mattvenn/teensy-audio-fx/docs/PO_sync_mode.md

# PO sync mode

looks for full amp sync pulse on 1/8 notes on left channel.

## sync pulse

* DC, 1v peak
* 2.7ms long pulse

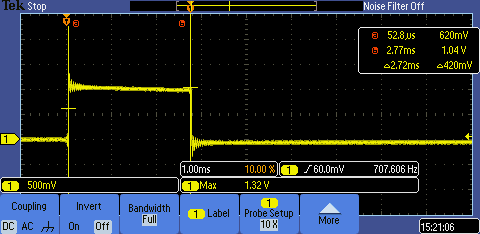
[picture p4: docs/po-sync-pulse.PNG]
sync pulse


## 2 sync pulses @ 120bpm

* showing 250ms spacing
* 120bpm is 2bps, so 8 pulses per bar of 16 steps
* 1 pulse every 2 steps

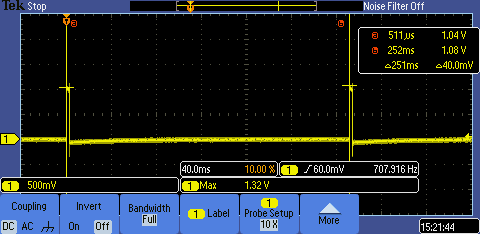
[picture p5: docs/po-sync-120bpm.PNG]
sync pulses at 120bpm
