mattvenn/teensy-audio-fx/docs/noise.md

# Noise and clock measurements

## I2S 12MHz clock

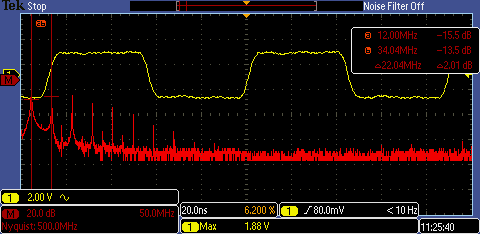
[picture p6: docs/i2s-clock.PNG]
i2s clock and fft


## Noise on input jack, nothing plugged in

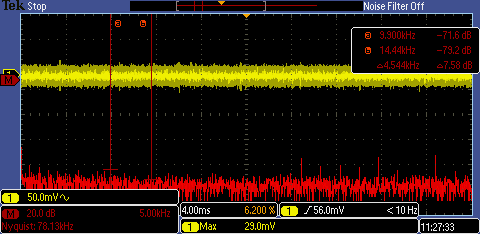
[picture p7: docs/input.PNG]
input jack


## Noise on output jack, nothing plugged in, nothing playing

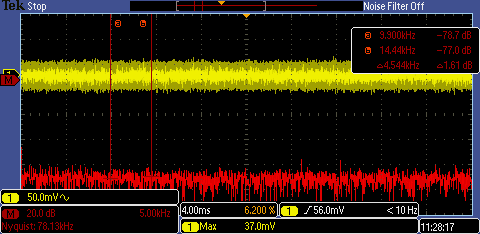
[picture p8: docs/output.PNG]
output jack
