mattvenn/teensy-audio-fx/docs/lrclk-bclk-swap.png

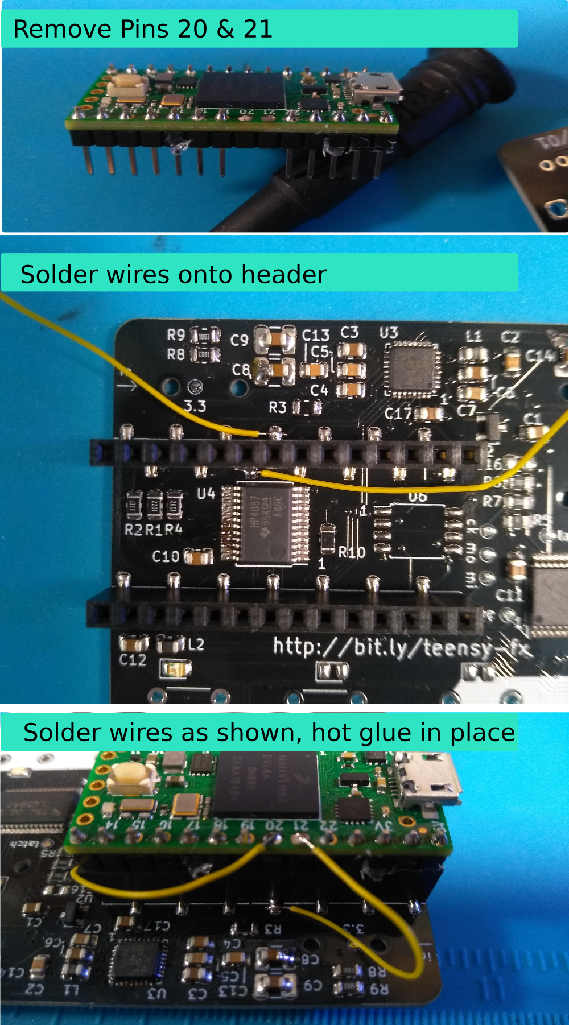
docs/lrclk-bclk-swap.png
