mattvenn/teensy-audio-fx/hardware/graphics/lab.png

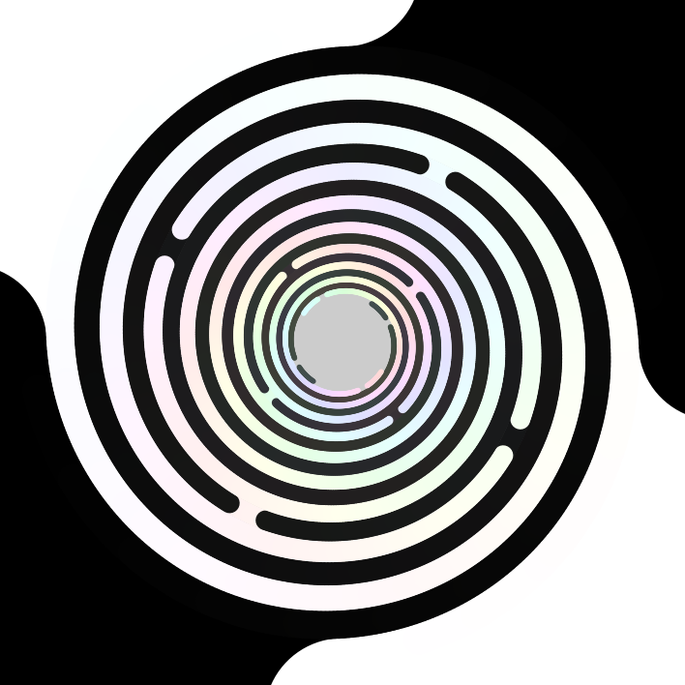
hardware/graphics/lab.png
