mattvenn/teensy-audio-fx/hardware/schematic_audio4.png

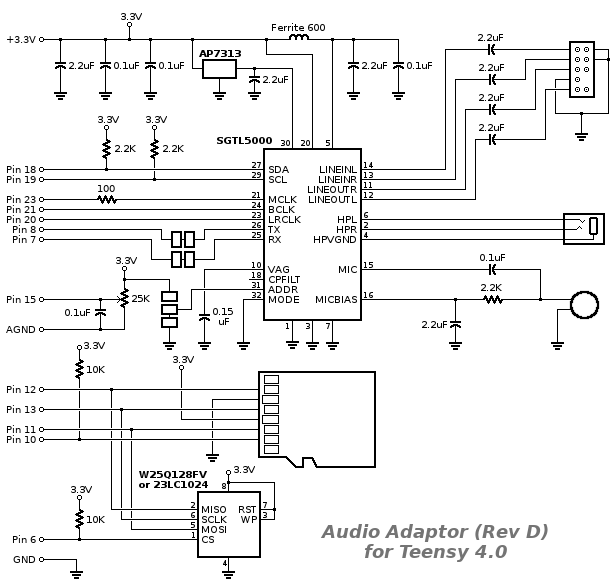
hardware/schematic_audio4.png
