mattvenn/teensy-audio-fx/hardware/teensy4.png

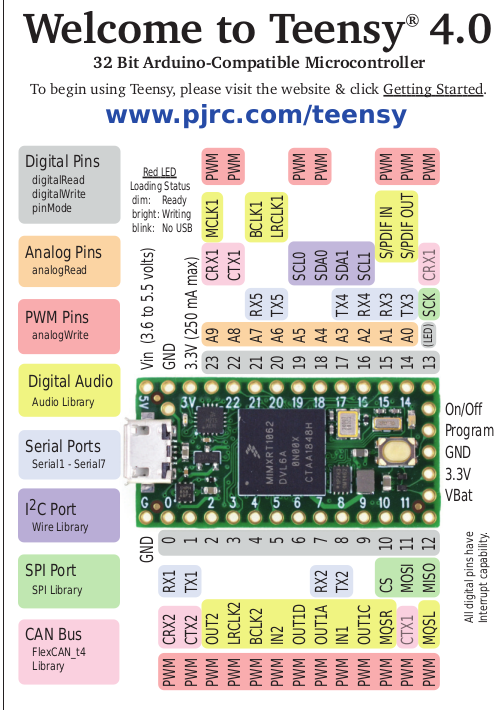
hardware/teensy4.png
