mattvenn/teensy-audio-fx/(threads)

Thread 8 (2020-09-01):

Add midi sync out

mattvenn, 2020-09-01:
Midi sync out doesn't look too hard to implement
Needs a few resistors, a socket and a lib. Test with kaoss pad first.

Thread 9 (2022-02-06):

Real noise target is mix_del not a mix_op

Atarity, 2022-02-06:
I've send source config to Teensy audio library GUI converter and found noise target is different from readme picture. The same is in  latest hex I've flash.

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
