mattvenn/teensy-audio-fx/hardware/teensy-fx.kicad_pcb

## KiCad design hardware/teensy-fx.kicad_pcb (2020-02-10)

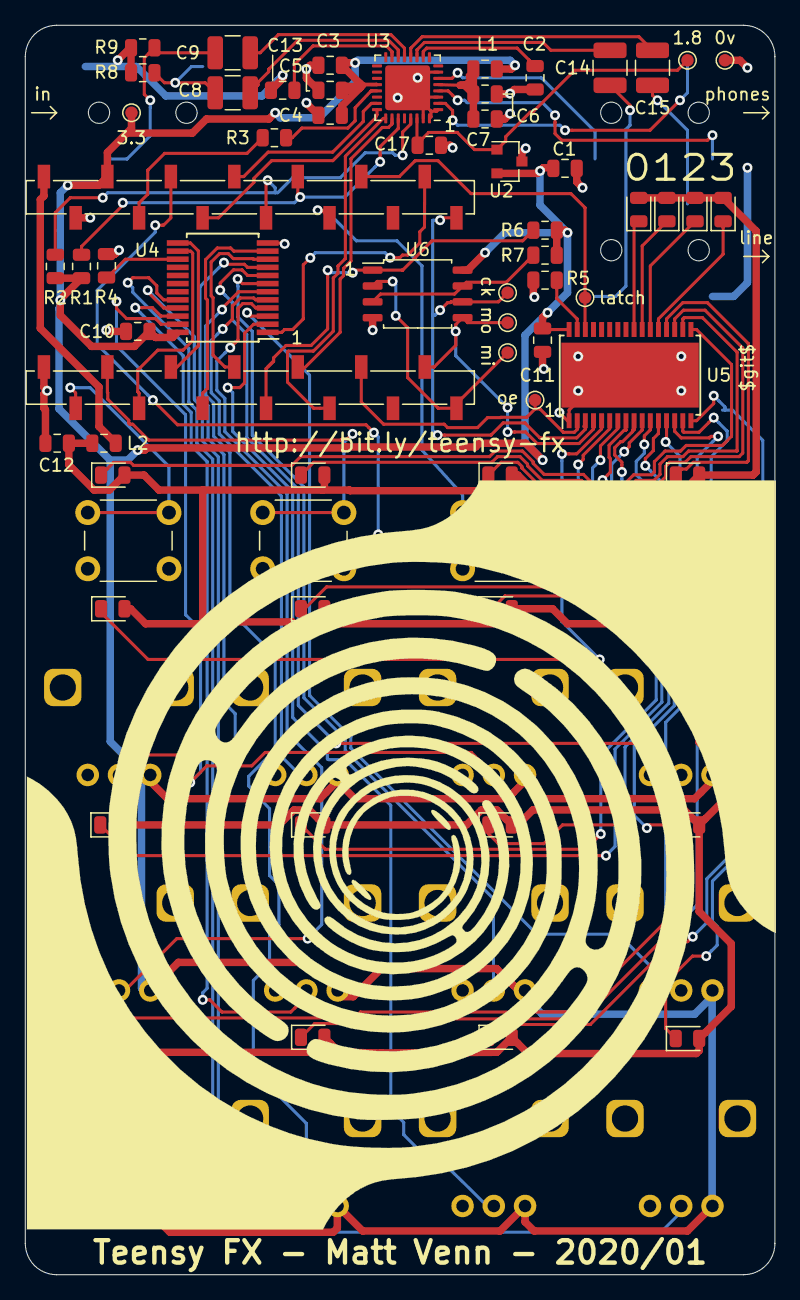
[picture p16: board teensy-fx.kicad_pcb from above]

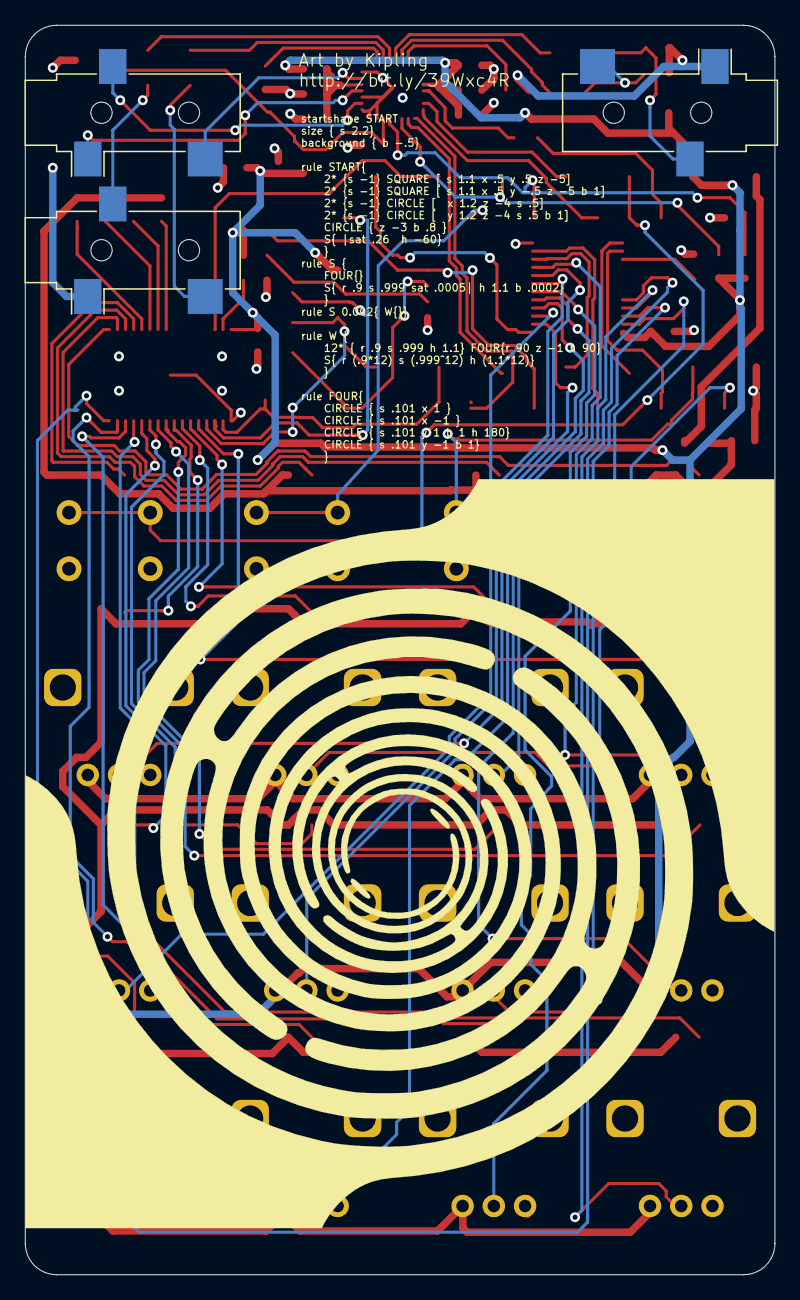
[picture p17: board teensy-fx.kicad_pcb from below]

Board: 4 copper layers, 60.0 x 100.0 mm, 80 parts (3 on the bottom side), 77 nets.

Parts:
C1, C3, C6, C10, C11, C12, C17: 2.2uF; C_0805_2012Metric
C2, C4, C5, C7, C13: 0.1uF; C_0805_2012Metric
C8, C9, C14, C15: 1uF; C_1210_3225Metric
D1, D2, D3, D4, D5, D6, D7, D8, D9, D10, D11, D12, D13, D14, D15, D16, D17, D18, D19, D20: LED; LED_0805_2012Metric
J1, J2, J3: AudioJack3_Ground; Jack_3.5mm_CUI_SJ-3523-SMT_Horizontal
L1, L2: 600R; L_0805_2012Metric
R1, R2: 2.2K; R_0805_2012Metric
R3: 100R; R_0805_2012Metric
R4, R6, R7: 10k; R_0805_2012Metric
R5: 4.7k; R_0805_2012Metric
R8, R9: 100k; R_0805_2012Metric
RV1, RV2, RV3, RV4, RV5, RV6, RV7, RV8, RV9, RV10, RV11, RV12: R_POT; Potentiometer_Alps_RK09L_Single_Vertical
SW1, SW2, SW3, SW4: Switch_SW_Push; SW_PUSH_6mm
TP1, TP2, TP3, TP4, TP5, TP6, TP7, TP8: TestPoint; TestPoint_Pad_D1.0mm
U1: Teensy4.0; teensy4smt
U2: MCP1811A; SOT-23
U3: SGTL5000; QFN-32-1EP_5x5mm_P0.5mm_EP3.6x3.6mm
U4: 4067; SSOP-24_5.3x8.2mm_P0.65mm
U5: TLC5947DAP; HTSSOP-32-1EP_6.1x11mm_P0.65mm_EP5.2x11mm_Mask4.11x4.36mm
U6: W25Q128JVS; SOIC-8_5.23x5.23mm_P1.27mm

Connections:
+1V8: C17.1, TP7.1, U2.1, U3.30
+3V3: C1.1, C3.1, C4.1, C5.1, C10.1, C11.1, L1.1, R1.1, R2.1, R6.1, R7.1, RV1.1, RV2.1, RV3.1, RV4.1, RV5.1, RV6.1, RV7.1, RV8.1, RV9.1, RV10.1, RV11.1, RV12.1, TP6.1, U1.31, U2.2, U3.20, U4.24, U5.32, U6.8
+5V: L2.1, U1.33
+5VA: C12.1, D1.2, D2.2, D3.2, D4.2, D5.2, D6.2, D7.2, D8.2, D9.2, D10.2, D11.2, D12.2, D13.2, D14.2, D15.2, D16.2, D17.2, D18.2, D19.2, D20.2, L2.2
/SGTL audio/filter_audio_3v3: C6.1, C7.1, L1.2, U3.5
/mem_cs: R6.2, U1.8, U6.1
/pots buttons & LEDs/a0: RV1.2, U4.9
/pots buttons & LEDs/a1: RV4.2, U4.8
/pots buttons & LEDs/a2: RV7.2, U4.7
/pots buttons & LEDs/a3: RV10.2, U4.6
/pots buttons & LEDs/a4: RV2.2, U4.5
/pots buttons & LEDs/a5: RV5.2, U4.4
/pots buttons & LEDs/a6: RV8.2, U4.3
/pots buttons & LEDs/a7: RV11.2, U4.2
/pots buttons & LEDs/a8: RV3.2, U4.23
/pots buttons & LEDs/a9: RV6.2, U4.22
/pots buttons & LEDs/a10: RV9.2, U4.21
/pots buttons & LEDs/a11: RV12.2, U4.20
BCLK: U1.28, U3.24
GND: C1.2, C2.2, C3.2, C4.2, C5.2, C6.2, C7.2, C10.2, C11.2, C12.2, C13.2, C17.2, J1.S, J3.S, R4.2, R5.2, R8.2, R9.1, RV1.3, RV2.3, RV3.3, RV4.3, RV5.3, RV6.3, RV7.3, RV8.3, RV9.3, RV10.3, RV11.3, RV12.3, SW1.2, SW2.2, SW3.2, SW4.2, TP8.1, U1.1, U1.32, U2.3, U3.1, U3.3, U3.7, U3.31, U3.32, U3.33, U4.12, U5.1, U5.33, U6.4
I2S_IN: U1.10, U3.25
I2S_OUT: U1.9, U3.26
LRCLK: U1.27, U3.23
MCLK: R3.2, U1.30
MISO: TP5.1, U1.14, U6.2
MOSI: TP3.1, U1.13, U5.4, U6.5
unnamed: C2.1, U3.10
unnamed: C8.1, U3.14
unnamed: C8.2, J1.T, R8.1
unnamed: C9.1, U3.13
unnamed: C9.2, J1.R, R9.2
unnamed: C13.1, U3.15
unnamed: C14.1, U3.11
unnamed: C14.2, J3.T
unnamed: C15.1, U3.12
unnamed: C15.2, J3.R
unnamed: D1.1, U5.5
unnamed: D2.1, U5.6
unnamed: D3.1, U5.7
unnamed: D4.1, U5.8
unnamed: D5.1, U5.9
unnamed: D6.1, U5.10
unnamed: D7.1, U5.11
unnamed: D8.1, U5.12
unnamed: D9.1, U5.13
unnamed: D10.1, U5.14
unnamed: D11.1, U5.15
unnamed: D12.1, U5.16
unnamed: D13.1, U5.17
unnamed: D14.1, U5.18
unnamed: D15.1, U5.19
unnamed: D16.1, U5.20
unnamed: D17.1, U5.21
unnamed: D18.1, U5.22
unnamed: D19.1, U5.23
unnamed: D20.1, U5.24
unnamed: J2.R, U3.2
unnamed: J2.S, U3.4
unnamed: J2.T, U3.6
unnamed: R3.1, U3.21
unnamed: R4.1, U4.15
unnamed: R5.1, U5.31
unnamed: R7.2, U6.3, U6.7
SCL: R2.2, U1.26, U3.29
SCLK: TP1.1, U1.20, U5.3, U6.6
SDA: R1.2, U1.25, U3.27
led_latch: TP4.1, U1.23, U5.30
led_oe: TP2.1, U1.11, U5.2
pot_b0: U1.7, U4.10
pot_b1: U1.6, U4.11
pot_b2: U1.4, U4.14
pot_b3: U1.5, U4.13
pot_multiplex: U1.21, U4.1
sw_1: SW1.1, U1.2
sw_2: SW2.1, U1.3
sw_3: SW3.1, U1.24
sw_4: SW4.1, U1.29
