mattvenn/teensy-audio-fx/(commit log)

2019-12-29 reset seq button
2020-01-02 bug fix on freq/res mixup, route noise direct to op, ping pong delay, half freq, save and load vals/seqs
    [control.py]
2020-01-02 first commit on pcb schematic
    [SGTL5000.sch, teensy-fx.kicad_pcb, teensy-fx.sch]
2020-01-02 initial schematic and parts layout
    [SGTL5000.sch, teensy-fx.kicad_pcb, teensy-fx.sch]
2020-01-03 switch to pwm led driver, first pass routing
    [SGTL5000.sch, teensy-fx.kicad_pcb, teensy-fx.sch]
2020-01-03 tidy schematic and finish layout
    [SGTL5000.sch, teensy-fx.kicad_pcb, teensy-fx.sch]
2020-01-03 made better fp for smt teensy, fixed some wiring errors
    [teensy-fx.kicad_pcb, teensy-fx.sch]
2020-01-03 added basic board control stuff to check for pin collisions
2020-01-03 missing files
    [pots.sch]
2020-01-03 try to fix the wiring a bit, signal integrity might be an issue with 2 layer and teensy breakout
    [pots.sch, teensy-fx.kicad_pcb]
2020-01-03 more leds
2020-01-03 move to 4 layer board, change size for cost, add optional flash
    [pots.sch, teensy-fx.kicad_pcb, teensy-fx.sch]
2020-01-03 moved sockets in 2mm
    [teensy-fx.kicad_pcb]
2020-01-03 fix noise filter bug
2020-01-04 fix sgtl5000 symbol error, add filter resistor and cap for unused mic input
    [SGTL5000.sch, teensy-fx.kicad_pcb, teensy-fx.sch]
2020-01-04 new layout following feedback from pjrc forum
    [SGTL5000.sch, teensy-fx.kicad_pcb, teensy-fx.sch]
2020-01-05 changed 3v3 to gnd plane under audio circuitry, added lineout jack
    [SGTL5000.sch, teensy-fx.kicad_pcb]
2020-01-05 try adding resistors to all the i2s lines
    [SGTL5000.sch, teensy-fx.kicad_pcb]
2020-01-06 change 3v3 plane to gnd, route all i2s signals on top plane, add rc filter for ADC pot input
    [SGTL5000.sch, pots.sch, teensy-fx.kicad_pcb]
2020-01-08 notes, check current, add extra decoupling cap for reg, move led supply to 5v
    [SGTL5000.sch, pots.sch, teensy-fx.kicad_pcb]
2020-01-11 fix teensy smt fp for molex part
    [teensy-fx.kicad_pcb]
2020-01-11 ready to order
    [teensy-fx.kicad_pcb]
2020-01-11 slightly improve ground layer by moving vias
    [teensy-fx.kicad_pcb]
2020-01-11 go back to circle holes after seeing gerbers exported ovals as offset circles
    [teensy-fx.kicad_pcb]
2020-01-11 add model number
    [pots.sch]
2020-01-11 added gerbers and config
2020-01-11 board and schematic updated
2020-01-11 added link to gerbers
2020-01-11 changed to LDO that I can source from farnell
    [SGTL5000.sch, pots.sch, teensy-fx.kicad_pcb]
2020-01-11 date format change
    [teensy-fx.kicad_pcb]
2020-01-11 farnell numbers
    [SGTL5000.sch, pots.sch, teensy-fx.sch]
2020-01-12 change farnell field to farnell #
    [SGTL5000.sch, pots.sch, teensy-fx.sch]
2020-01-12 fix library mess and get bom exported
    [SGTL5000.sch, pots.sch, teensy-fx-bom.csv, teensy-fx.kicad_pcb]
2020-01-12 missing silk graphics!
    [teensy-fx.kicad_pcb]
2020-01-12 cheaper caps and non-us 10k resistor
    [SGTL5000.sch, pots.sch, teensy-fx-bom.csv, teensy-fx.sch]
2020-02-03 start on OO firmware for board
2020-02-03 add farnell number for switches
    [pots.sch]
2020-02-04 added bar timer, tests and fix up fx.ino
2020-02-08 leds working on board, need to fix pots multiplex address, audio i2s lines arent working
2020-02-09 worked out why pot mux was weird, add erase button
2020-02-09 fix lrclk and bclk on schematic and readme notes
    [SGTL5000.sch]
2020-02-09 leds for bar timer
2020-02-09 led bar timer
2020-02-10 updates for extra control arg and sub millisecond bar timer
2020-02-10 fractional millisecond handling for better timing accuracy
2020-02-10 remove blanking except at init, and limit max led to 1023
2020-02-10 new control order, fix led max for bar and button leds, start bar timer after init light fade
2020-02-10 fix wiring & routing for lrclk and bclk, and removed lp filter behind pot mux
    [SGTL5000.sch, pots.sch, teensy-fx.kicad_pcb, teensy-fx.sch]
2020-02-10 new schematic and gerber export
2020-02-12 flip board upside down for easier button/led viewing, increase output vol
2020-02-15 simplify and improve sync, add leds feedback for buttons
2020-02-15 remove serial prints
2020-02-17 assembled 2nd board and discovered 1st board has blanking problem that led to led issues. increased MAX_LED to 4095 and got rid of erroneous LED_MAX
2020-02-17 image of wiring lrclk and bclk swap
2020-02-18 teensy link
2021-05-03 average beat_ms to get rid of jitter on the delay causing unwanted artifacts due to delay times changing
2021-05-03 keep track of freeverb
